barawn/radiant/README.md

# radiant
Hardware files and firmware for RADIANT

Schematic should be complete, including FPGA pinout.

# PCB files, bill of materials

See "Releases" for everything bundled together.
