barawn/radiant/CAMv3/README.txt

radiantv3.gtl : Top Copper
radiantv3.gl2 : Inner Layer 2
radiantv3.gl3 : Inner Layer 3
radiantv3.gl4 : Inner Layer 4
radiantv3.gl5 : Inner Layer 5
radiantv3.gl6 : Inner Layer 6
radiantv3.gl7 : Inner Layer 7
radiantv3.gbl : Bottom Copper
radiantv3.gto : Top Silkscreen
radiantv3.gbo : Bottom Silkscreen
radiantv3.gts : Top Soldermask
radiantv3.gbs : Bottom Soldermask
radiantv3.gtp : Top Solderpaste
radiantv3.gbp : Bottom Solderpaste
radiantv3.gko : Outline

radiantv3.txt : NC Drill

Designed with a stackup of

top 1 oz copper
5.9 mils (2x1080)
inner layer 2 1 oz copper
9 mils (core)
inner layer 3 1 oz copper
7.3 mils (7628)
inner layer 4 1 oz copper
5.1 mils (core)
inner layer 5 1 oz copper
7.3 mils (7628)
inner layer 6 1 oz copper
9 mils (core)
inner layer 7 1 oz copper
5.9 mils (2x1080)
bottom 1 oz copper
