barawn/radiant/CAM/README.txt

radiantv2.gtl : Top Copper
radiantv2.gl2 : Inner Layer 2
radiantv2.gl3 : Inner Layer 3
radiantv2.gl4 : Inner Layer 4
radiantv2.gl5 : Inner Layer 5
radiantv2.gl6 : Inner Layer 6
radiantv2.gl7 : Inner Layer 7
radiantv2.gbl : Bottom Copper
radiantv2.gto : Top Silkscreen
radiantv2.gbo : Bottom Silkscreen
radiantv2.gts : Top Soldermask
radiantv2.gbs : Bottom Soldermask
radiantv2.gtp : Top Solderpaste
radiantv2.gbp : Bottom Solderpaste

radiantv2.txt : NC Drill

Designed with a stackup of

top 1 oz copper
5.9 mils (2x1080)
inner layer 2 1 oz copper
9 mils (core)
inner layer 3 1 oz copper
7.3 mils (7628)
inner layer 4 1 oz copper
5.1 mils (core)
inner layer 5 1 oz copper
7.3 mils (7628)
inner layer 6 1 oz copper
9 mils (core)
inner layer 7 1 oz copper
5.9 mils (2x1080)
bottom 1 oz copper
