barawn/radiant/radiant_v3_bom.xlsx

Line # | Qty | Ref Des | Part Name (internal use) | Part Decal (internal use) | Manufacturer | Part Number | Description
1 | 1 | L15 | 744314330 | IND_744314330 | Wurth Elektronik | 744314330 | FIXED IND 3.3UH 9A 9 MOHM SMD
2 | 1 | J15 | 2147110001 | 21471100001 | Molex | 204711-0001 | Vertical Type C Usb Connector Rohs Compliant: Yes
3 | 24 | R1A R1B R1C R1D R1E R1F R1G R1H R1I R1J R1K R1L R1M R1N R1O R1P R1Q R1R R1S R1T R1U R1V R1W R1X | 1005L_OPTION,DNI | 1005L_PAD_OPTION | DNI |  | DNI
4 | 1 | J7 | 1888174-6 | 1888174-2 | TE Connectivity | 1888174-2 | CONN MINI SAS RCPT 36POS SLD SMD
5 | 4 | J18-21 | 1909763-1 | 1909763-1 | TE Connectivity | 1909763-1 | TE CONNECTIVITY - 1909763-1 - RF COAXIAL, UMCC, JACK, 50 OHM, PCB
6 | 1 | J17 | 20021121-00010C4LF | 2002112100010C4LF | Amphenol | 20021121-00010C4LF | Headers & Wire Housings 1.27x1.27mm BTB, Hdr Unshrd, SMT, 10 Pos
7 | 6 | S4-9 | 2182LPSTF | 2182LPSTF | CTS | 2182LPSTF | DIP SW,Half-pitch,2-pos,flush act, SMD 2 Way Surface Mount DIP Switch SPDT, Piano Actuator
8 | 1 | J12 | 5566-4 | 5566-4 | Molex | 39281043 | Mini-Fit Jr. Vertical Header, 4.20mm Pitch, Dual Row, 4 Circuits, without Snap-in Plastic Peg PCB Lock, Tin, Natural
9 | 1 | U4 | 74AUP1T50 | SC70-5 | TI | SN74AUP1T50DCKR | Low Power, 1.8/2.5/3.3-V Input, 3.3-V CMOS Output, Single Schmitt-Trigger Buffer Gate 5-SC70 -40 to 85
10 | 30 | U5-6 U37-39 U42-66 | 74HC4051BQ_115 | SOT763-1 | Nexperia | 74HC4051BQ,115 | 74HC4052BQ,115 Nexperia, Multiplexer Switch IC, 16-Pin DHVQFN
11 | 1 | U1 | ADF4351BCPZRL7 | QFN50P500X500X10033N | Analog | ADF4351BCPZ-RL7 | Wideband_Synthesizer_with_Integrated_VCO
12 | 6 | V1 V10 V27 V36 V45 V54 | AOZ1375DI | SON45P300X300X8013N165X238 | Alpha & Omega | AOZ1375DI-01 | IC PWR SWITCH N-CHAN 1:1 12DFN
13 | 1 | U8 | ATSAMD21J1XX-MU | QFN5-9X9-64-EP-65 | Microchip | ATSAMD21J18A-MU | MICROCHIP - ATSAMD21J18A-MU - MCU, 32BIT, CORTEX-M0+, 48MHZ, QFN-64
14 | 1 | S16 | B3U-1100PM-B | B3U-1100P-B | Omron | B3U-1100P | Switch Tactile N.O. SPST Round Button Gull Wing 0.05A 12VDC 1.5N SMD Embossed T/R
15 | 24 | U2A U2B U2C U2D U2E U2F U2G U2H U2I U2J U2K U2L U2M U2N U2O U2P U2Q U2R U2S U2T U2U U2V U2W U2X | BGA420 | SOT-343-BGA420 | Infineon | BGA420H6327XTSA1 | BGA420 Series 2.3 dB 6 V Surface Mount Si-MMIC Amplifier - SOT-343
16 | 24 | U1A U1B U1C U1D U1E U1F U1G U1H U1I U1J U1K U1L U1M U1N U1O U1P U1Q U1R U1S U1T U1U U1V U1W U1X | BGA-2851 | SOT-363 | NXP | BGA2802,115 | RF Amplifier IC General Purpose 0Hz ~ 2.2GHz 6-TSSOP
17 | 44 | C274-281 C284-291 C294-297 C478-485 C488-495 C498-501 CX497-498 CX500-501 | CAPACITOR_LST,0.1 uF-0201 | CAP0603L | Taiyo Yuden | LMK063C6104KP-F | CAP CER MLCC - SMD/SMT 0201 10V 0.1uF 10% X6S
18 | 347 | C48 C51 C56 C60 C62 C64 C66 C68 C70 C72-73 C80 C84 C86 C95 C97-101 C107-108 C110 C112 C117 C119 C121 C131-132 C134 C136 C148 C150 C161 C163 C171 C173 C177 C182 C184 C195 C197 C208 C210 C221 C223 C229 C232 C234-235 C242 C244-245 C253 C261 C298-299 C308 C310 C321 C323 C334 C336 C347 C349 C355 C358-359 C368 C370 C381 C383 C394 C396 C407 C409 C415 C418-419 C428 C430 C441 C443 C454 C456 C467 C469 C475 C502-503 C573-575 CX2-3 CX8-24 CX26-27 CX32-36 CX38-39 CX44-48 CX50-51 CX56-60 CX62 CX64 CX66 CX68-69 CX71-72 CX74-77 CX82 CX84-85 CX90-94 CX96 CX98-99 CX104-108 CX110 CX112-113 CX118-122 CX124 CX142-143 CX145-149 CX156 CX158-159 CX164-168 CX172 CX174-175 CX180-184 CX188 CX190-191 CX196-200 CX204 CX206-207 CX209-213 CX220 CX222-223 CX228-232 CX236 CX238-239 CX244-248 CX252 CX254-255 CX260-264 CX268 CX270-271 CX273-277 CX284 CX286-287 CX292-296 CX300 CX302-303 CX308-312 CX316 CX318-319 CX324-328 CX332 CX334-335 CX337-341 CX348 CX350-351 CX356-360 CX364 CX366-367 CX372-376 CX380 CX382-383 CX388-392 CX396-436 CX438 CX443-444 CX489 CX552-557 | CAPACITOR_LST,0.1u | CAP1005L | KEMET | C0402C104K4RECAUTO | CAP CER MLCC - SMD/SMT 16V 0.1uF X7R 0402 10% AEC-Q200
19 | 105 | C505-529 C547-569 CX441 CX458-471 CX473-475 CX481-487 CX492-495 CX504-507 CX510-513 CX516-519 CX522-525 CX529-532 CX535-538 CX541-544 | CAPACITOR_LST,0.47u | CAP0603L | Taiyo Yuden | LMK063BC6474KPLF | CAP CER MLCC - SMD/SMT 0201 10V 0.47uF 10% X6S
20 | 96 | C1A C1B C1C C1D C1E C1F C1G C1H C1I C1J C1K C1L C1M C1N C1O C1P C1Q C1R C1S C1T C1U C1V C1W C1X C5A C5B C5C C5D C5E C5F C5G C5H C5I C5J C5K C5L C5M C5N C5O C5P C5Q C5R C5S C5T C5U C5V C5W C5X C6A C6B C6C C6D C6E C6F C6G C6H C6I C6J C6K C6L C6M C6N C6O C6P C6Q C6R C6S C6T C6U C6V C6W C6X C7A C7B C7C C7D C7E C7F C7G C7H C7I C7J C7K C7L C7M C7N C7O C7P C7Q C7R C7S C7T C7U C7V C7W C7X | CAPACITOR_LST,1 nF | CAP1005L | TDK | CGA2B2C0G1H102J050BA
21 | 165 | C2-4 C6-7 C9-15 C18-23 C26-31 C82 C87 C89 C91 C93 C123-126 C128 C138-142 C144-146 C152-158 C165-169 C179 C185 C188-192 C198 C201-205 C211 C214-218 C224 C231 C255 C263 C301-305 C311 C314-318 C324 C327-331 C337 C340-344 C350 C357 C361-365 C371 C374-378 C384 C387-391 C397 C400-404 C410 C417 C421-425 C431 C434-438 C444 C447-451 C457 C460-464 C470 C477 C576-581 CX437 CX545-550 | CAPACITOR_LST,1 uF | CAP1005L | Murata | GRM155C81C105KE11J | CAP CER MLCC - SMD/SMT 1.0UF 16V 10% 0402
22 | 217 | C81 C83 C85 C94 C96 C109 C111 C116 C118 C133 C135 C147 C149 C160 C162 C170 C172 C178 C181 C183 C194 C196 C207 C209 C220 C222 C230 C233 C243 C256-257 C264-265 C271 C282-283 C292-293 C307 C309 C320 C322 C333 C335 C346 C348 C356 C367 C369 C380 C382 C393 C395 C406 C408 C416 C427 C429 C440 C442 C453 C455 C466 C468 C476 C486-487 C496-497 C570 C572 CX1 CX4-7 CX25 CX28-31 CX37 CX40-43 CX49 CX52-55 CX61 CX63 CX65 CX67 CX70 CX73 CX78-81 CX83 CX86-89 CX95 CX97 CX100-103 CX109 CX111 CX114-117 CX123 CX141 CX144 CX150-152 CX155 CX157 CX160-163 CX171 CX173 CX176-179 CX187 CX189 CX192-195 CX203 CX205 CX208 CX214-216 CX219 CX221 CX224-227 CX235 CX237 CX240-243 CX251 CX253 CX256-259 CX267 CX269 CX272 CX278-280 CX283 CX285 CX288-291 CX299 CX301 CX304-307 CX315 CX317 CX320-323 CX331 CX333 CX336 CX342-344 CX347 CX349 CX352-355 CX363 CX365 CX368-371 CX379 CX381 CX384-387 CX395 CX439-440 | CAPACITOR_LST,10 uF | CAP1608L | Taiyo Yuden | LMK107BBJ106KALT | CAP CER MLCC - SMD/SMT 0603 10V 10uF 10% X5R
23 | 24 | C1 C5 C17 C25 C122 C137 C143 C151 C164 C187 C200 C213 C300 C313 C326 C339 C360 C373 C386 C399 C420 C433 C446 C459 | CAPACITOR_LST,100p | CAP1005L | TDK | CGA2B2C0G2A101J050BE | CAP CER MLCC - SMD/SMT 0402 100V 100pF 5% SOFT 0.50mm AEC-Q200
24 | 1 | CX472 | CAPACITOR_LST,100u | CAP3216L | Samsung | CL31A107MQHNNNE | CAP CER 100UF 6.3V X5R 1206
25 | 223 | C38 C49 C57 C77-79 C102-103 C113-115 C120 C127 C129-130 C159 C174-176 C180 C193 C206 C219 C226-228 C306 C319 C332 C345 C352-354 C366 C379 C392 C405 C412-414 C426 C439 C452 C465 C472-474 C534 C541-546 C571 C10A C10B C10C C10D C10E C10F C10G C10H C10I C10J C10K C10L C10M C10N C10O C10P C10Q C10R C10S C10T C10U C10V C10W C10X C18A C18B C18C C18D C18E C18F C18G C18H C18I C18J C18K C18L C18M C18N C18O C18P C18Q C18R C18S C18T C18U C18V C18W C18X C19A C19B C19C C19D C19E C19F C19G C19H C19I C19J C19K C19L C19M C19N C19O C19P C19Q C19R C19S C19T C19U C19V C19W C19X C27A C27B C27C C27D C27E C27F C27G C27H C27I C27J C27K C27L C27M C27N C27O C27P C27Q C27R C27S C27T C27U C27V C27W C27X C9A C9B C9C C9D C9E C9F C9G C9H C9I C9J C9K C9L C9M C9N C9O C9P C9Q C9R C9S C9T C9U C9V C9W C9X CX561-608 | CAPACITOR_LST,10n | CAP1005L | Murata | GRM1555CYA103GE01D | CAP CER 10000PF 35V C0G/NP0 0402
26 | 61 | C40 C50 C55 C58-59 C61 C63 C65 C67 C69 C71 C252 C260 C12A C12B C12C C12D C12E C12F C12G C12H C12I C12J C12K C12L C12M C12N C12O C12P C12Q C12R C12S C12T C12U C12V C12W C12X C21A C21B C21C C21D C21E C21F C21G C21H C21I C21J C21K C21L C21M C21N C21O C21P C21Q C21R C21S C21T C21U C21V C21W C21X | CAPACITOR_LST,10p | CAP1005L | KEMET | C0402C100K8GACTU | CAP CER 10PF 10V NP0 0402
27 | 1 | C237 | CAPACITOR_LST,150p | CAP1005L | KEMET | C0402C151J3GAC7867 | CAP CER 150PF 25V NP0 0402
28 | 19 | C41 C28M C28N C28O C28P C28Q C28R C28S C28T C28U C29M C29N C29O C29P C29Q C29R C29S C29T C29U | CAPACITOR_LST,15p | CAP1005L | KEMET | C0402C150G5HACAUTO | CAP CER MLCC - SMD/SMT 50V 15pF X8R 0402 2% AEC-Q200
29 | 1 | C34 | CAPACITOR_LST,16p | CAP1005L | Murata | GJM1555C1H160GB01D | CAP CER MLCC - SMD/SMT 0402 16pF 50Volts C0G 2%
30 | 48 | C13A C13B C13C C13D C13E C13F C13G C13H C13I C13J C13K C13L C13M C13N C13O C13P C13Q C13R C13S C13T C13U C13V C13W C13X C22A C22B C22C C22D C22E C22F C22G C22H C22I C22J C22K C22L C22M C22N C22O C22P C22Q C22R C22S C22T C22U C22V C22W C22X | CAPACITOR_LST,2.2p | CAP1005L | AVX | 04025A2R2KAT2A | CAP CER 2.2PF 50V C0G/NP0 0402
31 | 10 | C52 C238 C248 C254 C262 C272 C530-533 | CAPACITOR_LST,2.7n | CAP1005L | KEMET | C0402C272K5RACAUTO | MLCC - SMD/SMT 50V 2700pF X7R 0402 10% AEC-Q200
32 | 1 | C42 | CAPACITOR_LST,2.7p | CAP1005L | KEMET | CBR04C279A5GAC | CAP CER MLCC - SMD/SMT 50V 2.7pF C0G 0402 0.05pF
33 | 1 | C33 | CAPACITOR_LST,20p | CAP1005L | KEMET | C0402C200F4HACAUTO | CAP CER MLCC - SMD/SMT 16V 20pF X8R 0402 1% AEC-Q200
34 | 26 | C104-105 C8A C8B C8C C8D C8E C8F C8G C8H C8I C8J C8K C8L C8M C8N C8O C8P C8Q C8R C8S C8T C8U C8V C8W C8X | CAPACITOR_LST,220p | CAP1005L | KEMET | C0402C221J5RACAUTO | MLCC - SMD/SMT 50V 220pF X7R 0402 5% AEC-Q200
35 | 1 | C246 | CAPACITOR_LST,22n | CAP1005L | Murata | GRM155R71E223KA61D | CAP CER 0.022UF 25V X7R 0402
36 | 5 | C258-259 C266-267 C270 | CAPACITOR_LST,22u | CAP3216L | Taiyo Yuden | JMK316AB7226KL-TR | CAP CER MLCC - SMD/SMT 1206 6.3VDC 22uF 10% X7R
37 | 6 | C535-540 | CAPACITOR_LST,27n | CAP1005L | KEMET | C0402C273K8RACTU | Multilayer Ceramic Capacitors MLCC - SMD/SMT 10V 0.027uF X7R 0402 10%
38 | 25 | C37 C3A C3B C3C C3D C3E C3F C3G C3H C3I C3J C3K C3L C3M C3N C3O C3P C3Q C3R C3S C3T C3U C3V C3W C3X | CAPACITOR_LST,27p | CAP1005L | Taiyo Yuden | UMK105CH270JVHF | CAP CER 27PF 50V CH 0402
39 | 48 | C14A C14B C14C C14D C14E C14F C14G C14H C14I C14J C14K C14L C14M C14N C14O C14P C14Q C14R C14S C14T C14U C14V C14W C14X C23A C23B C23C C23D C23E C23F C23G C23H C23I C23J C23K C23L C23M C23N C23O C23P C23Q C23R C23S C23T C23U C23V C23W C23X | CAPACITOR_LST,36p | CAP1005L | KEMET | CBR04C360F5GAC | CAP CER MLCC - SMD/SMT 50V 36pF C0G 0402 1%
40 | 1 | C236 | CAPACITOR_LST,39.0n | CAP1005L | Murata | GRM155R71H393KE14D | Cap Ceramic 0.039uF 50V X7R 10% Pad SMD 0402 125C T/R
41 | 48 | C17A C17B C17C C17D C17E C17F C17G C17H C17I C17J C17K C17L C17M C17N C17O C17P C17Q C17R C17S C17T C17U C17V C17W C17X C26A C26B C26C C26D C26E C26F C26G C26H C26I C26J C26K C26L C26M C26N C26O C26P C26Q C26R C26S C26T C26U C26V C26W C26X | CAPACITOR_LST,39p | CAP1005L | KEMET | C0402C390F5HACTU | CAP CER MLCC - SMD/SMT 50V 39pF X8R 0402 1%
42 | 109 | C8 C16 C24 C32 C88 C90 C92 C106 C186 C199 C212 C225 C268 C312 C325 C338 C351 C372 C385 C398 C411 C432 C445 C458 C471 CX125-140 CX153-154 CX169-170 CX185-186 CX201-202 CX217-218 CX233-234 CX249-250 CX265-266 CX281-282 CX297-298 CX313-314 CX329-330 CX345-346 CX361-362 CX377-378 CX393-394 CX442 CX446-457 CX477-480 CX490-491 CX496 CX499 CX502-503 CX508-509 CX514-515 CX520-521 CX527-528 CX533-534 CX539-540 CX551 | CAPACITOR_LST,4.7u | CAP1005L | AVX | 0402ZD475KAT2A | CAP CER MLCC - SMD/SMT 10V 4.7uF X5R 0402 0.1
43 | 4 | C239-240 C249-250 | CAPACITOR_LST,47 uF-1206 | CAP3216L | Taiyo Yuden | LMK316ABJ476ML-T | 1206 47 uF 10 V ±20% Tolerance X5R SMT Multilayer Ceramic Capacitor
44 | 7 | C44-47 C74-76 | CAPACITOR_LST,470p | CAP1005L | TDK | CGA2B2C0G2A471J050BE | CAP CER MLCC - SMD/SMT 0402 100V 470pF 5% SOFT C0G AEC-Q200
45 | 1 | C53 | CAPACITOR_LST,47n | CAP1005L | Yageo | CC0402KRX7R6BB473 | CAP CER 0.047UF 10V X7R 0402
46 | 1 | C35 | CAPACITOR_LST,47p | CAP1005L | Murata | GJM1555C1H470FB01D | CAP CER MLCC - SMD/SMT 47PF 50V 1% 0402
47 | 3 | C241 C251 C582 | CAPACITOR_LST,47u | CAP3225L | Taiyo Yuden | TMK325ABJ476MM-T | CAP CER 47UF 25V X5R 1210
48 | 4 | C269 CX476 CX488 CX526 | CAPACITOR_LST,47u | CAP2012L | Murata | GRM21BR60J476ME15L | CAP CER MLCC - SMD/SMT 0805 47uF 6.3volts *Derate Voltage/Temp
49 | 2 | C36 C39 | CAPACITOR_LST,5.6p | CAP1005L | AVX | 04025U5R6B4T2A | CAP CER MLCC - SMD/SMT 50V 5.6pF C0G 0402 0.1pF To
50 | 1 | C54 | CAPACITOR_LST,680p | CAP1005L | TDK | C1005C0G2A681J050BE | CAP CER MLCC - SMD/SMT 0402 100V 680pF 5% SOFT 0.50mm
51 | 97 | C247 C15A C15B C15C C15D C15E C15F C15G C15H C15I C15J C15K C15L C15M C15N C15O C15P C15Q C15R C15S C15T C15U C15V C15W C15X C16A C16B C16C C16D C16E C16F C16G C16H C16I C16J C16K C16L C16M C16N C16O C16P C16Q C16R C16S C16T C16U C16V C16W C16X C24A C24B C24C C24D C24E C24F C24G C24H C24I C24J C24K C24L C24M C24N C24O C24P C24Q C24R C24S C24T C24U C24V C24W C24X C25A C25B C25C C25D C25E C25F C25G C25H C25I C25J C25K C25L C25M C25N C25O C25P C25Q C25R C25S C25T C25U C25V C25W C25X | CAPACITOR_LST,68p | CAP1005L | KEMET | C0402C680J5GACAUTO | CAP CER MLCC - SMD/SMT 50V 68pF C0G 0402 5% AEC-Q200
52 | 48 | C11A C11B C11C C11D C11E C11F C11G C11H C11I C11J C11K C11L C11M C11N C11O C11P C11Q C11R C11S C11T C11U C11V C11W C11X C20A C20B C20C C20D C20E C20F C20G C20H C20I C20J C20K C20L C20M C20N C20O C20P C20Q C20R C20S C20T C20U C20V C20W C20X | CAPACITOR_LST,7.5p | CAP1005L | Murata | GJM1555C1H7R5BB01D | CAP CER MLCC - SMD/SMT 0402 7.5pF 50Volts C0G +/-0.1pF
53 | 24 | C4A C4B C4C C4D C4E C4F C4G C4H C4I C4J C4K C4L C4M C4N C4O C4P C4Q C4R C4S C4T C4U C4V C4W C4X | CAPACITOR_LST,82p | CAP1005L | Taiyo Yuden | UMK105CH820JVHF | CAP CER 82PF 50V CH 0402
54 | 1 | C43 | CAPACITOR_LST,9.1p | CAP1005L | KEMET | CBR04C919B5GAC | MLCC - SMD/SMT 50V 9.1pF C0G 0402 0.1pF
55 | 30 | C28A C28B C28C C28D C28E C28F C28G C28H C28I C28J C28K C28L C28V C28W C28X C29A C29B C29C C29D C29E C29F C29G C29H C29I C29J C29K C29L C29V C29W C29X | CAPACITOR_LST,DNI | CAP1005L | DNI | DNI | DNI
56 | 24 | C2A C2B C2C C2D C2E C2F C2G C2H C2I C2J C2K C2L C2M C2N C2O C2P C2Q C2R C2S C2T C2U C2V C2W C2X | CAPACITOR_LST_SQ,82p | CAP1005L_SQUARE | Taiyo Yuden | UMK105CH820JVHF | CAP CER 82PF 50V CH 0402
57 | 24 | C30A C30B C30C C30D C30E C30F C30G C30H C30I C30J C30K C30L C30M C30N C30O C30P C30Q C30R C30S C30T C30U C30V C30W C30X | CAPACITOR_LST_SQ,DNI | CAP1005L_SQUARE | DNI | DNI | DNI
58 | 3 | CX558-560 | CAPPOL_SMT,47 uF | CAPT7343HL | AVX | TCJY476M020R0070E | CAP TANT POLY 47UF 20V 2917
59 | 1 | CX445 | CAPPOL_SMT,680 uF | CAPT7343HL | Panasonic | 2R5TAE680ML | Cap Tant Solid 680uF 2.5V D3L CASE 20% (7.3 X 4.3 X 2.8mm) SMD 7343-30 0.025 Ohm 105°C T/R
60 | 2 | U14 U35 | CDCLVD1212RHAT | QFN50P600X600X10041N | Texas Instruments | CDCLVD1212RHAT | Low Jitter, 2-Input Selectable 1:12 Universal-to-LVDS Buffer
61 | 2 | L16-17 | CLF7045NIT-3R3N-D | INDM7470X480N | TDK | CLF7045NIT-3R3N-D | Fixed Inductors 3.3uH 0.016ohms 4.7A 30% AEC-Q200
62 | 2 | J1 J3 | CON-SIP-1P | SIP-1P | DNI | DNI | DNI
63 | 1 | J24 | CON-SIP-3P | SIP-3P | DNI | DNI | GENERIC 3 PIN SIP HEADER .100 CENTERS
64 | 6 | J2 J4-5 J8-10 | CON-SIP-4P | SIP-4P-LOCKING | DNI | DNI | DNI
65 | 49 | D1-24 D27 D30-53 | DIODE-SMD | DIOSOD-323 | Toshiba | CUS08F30,H3F
66 | 1 | Z1 | DIODE-ZENER-SMD,10V | DIOSOD-523 | Diodes, Inc. | BZT52C12T-7
67 | 1 | Y1 | DSC6001 | 7M_32X25 | Microchip | DSC6001CI1A-010.0000 | MEMS OSC XO 10.0000MHZ CMOS SMD
68 | 5 | D25-26 D28-29 D54 | DT1446 | DT1446 | Diodes, Inc. | DT1446-04S-7 | TVS DIODE 5V 8.5V SOT363
69 | 6 | L5-10 | FERRITE | 402 | Murata | BLM15PX800SN1D
70 | 1 | J22 | HEADER02 | SIP-2P | DNI | DNI | DNI
71 | 2 | J25-26 | HEADER02 | SIP-2P |  |  | TWO PIN INLINE HEADER; 100 MIL CENTERS
72 | 1 | J23 | HEADER02-1 | SIP-2P |  |  | TWO PIN HEADER; 100 MIL CENTERS; INLINE
73 | 15 | L10A L10B L10C L10D L10E L10F L10G L10H L10I L10J L10K L10L L10V L10W L10X | INDUCTOR,0 | 603 | Stackpole | RMCF0603ZT0R00 | 0 ohm 0603 resistor (short)
74 | 102 | L11-13 L20-22 L4A L4B L4C L4D L4E L4F L4G L4H L4I L4J L4K L4L L4M L4N L4O L4P L4Q L4R L4S L4T L4U L4V L4W L4X L5A L5B L5C L5D L5E L5F L5G L5H L5I L5J L5K L5L L5M L5N L5O L5P L5Q L5R L5S L5T L5U L5V L5W L5X L7A L7B L7C L7D L7E L7F L7G L7H L7I L7J L7K L7L L7M L7N L7O L7P L7Q L7R L7S L7T L7U L7V L7W L7X L8A L8B L8C L8D L8E L8F L8G L8H L8I L8J L8K L8L L8M L8N L8O L8P L8Q L8R L8S L8T L8U L8V L8W L8X | INDUCTOR,120n | 603 | Murata | LQW18ASR12G0ZD
75 | 48 | L6A L6B L6C L6D L6E L6F L6G L6H L6I L6J L6K L6L L6M L6N L6O L6P L6Q L6R L6S L6T L6U L6V L6W L6X L9A L9B L9C L9D L9E L9F L9G L9H L9I L9J L9K L9L L9M L9N L9O L9P L9Q L9R L9S L9T L9U L9V L9W L9X | INDUCTOR,150n | 603 | Wurth Elektronik | 744917215
76 | 24 | L3A L3B L3C L3D L3E L3F L3G L3H L3I L3J L3K L3L L3M L3N L3O L3P L3Q L3R L3S L3T L3U L3V L3W L3X | INDUCTOR,1u | 805 | Taiyo Yuden | LBR2012T1R0M
77 | 1 | L3 | INDUCTOR,20n | 805 | Murata | LQW2BAN20NG00L | FIXED IND 20NH 2.2A 50 MOHM
78 | 1 | L4 | INDUCTOR,33n | 805 | Murata | LQW2BAN33NG00L | FIXED IND 33NH 1.5A 120 MOHM
79 | 9 | L10M L10N L10O L10P L10Q L10R L10S L10T L10U | INDUCTOR,43n | 603 | Murata | LQW18AN43NG00D | CERAMIC CHIP INDUCTORS 43NH
80 | 1 | L1 | INDUCTOR,68n | 805 | Murata | LQW2BAN68NG00L | FIXED IND 68NH 1.25A 200 MOHM
81 | 48 | L1A L1B L1C L1D L1E L1F L1G L1H L1I L1J L1K L1L L1M L1N L1O L1P L1Q L1R L1S L1T L1U L1V L1W L1X L2A L2B L2C L2D L2E L2F L2G L2H L2I L2J L2K L2L L2M L2N L2O L2P L2Q L2R L2S L2T L2U L2V L2W L2X | INDUCTOR,82n | 805 | Murata | LQW2BAN82NJ00L | FIXED IND 82NH 1.2A 240 MOHM
82 | 1 | L2 | INDUCTOR,91n | 805 | Murata | LQW2BAN91NJ00L | FIXED IND 91NH 1.3A 210 MOHM
83 | 1 | L18 | INDUCTOR-SMD2,4.7u | IND2520L | TDK | MLP2520S4R7ST0S1 | FIXED IND 4.7UH 1A 110 MOHM SMD
84 | 1 | J16 | JTAG_2MM | 878321422 | Molex | 87832-1422 | Conn Shrouded Header (4 Sides) HDR 14 POS 2mm Solder ST Top Entry SMD Milli-Grid™ Tube
85 | 24 | LAB1-24 | LAB4D | LAB4D | Customer Supplied | LAB4D | Customer Supplied
86 | 2 | U13 U34 | LCMXO2-2K/4K/7K-BG256 | BGA256C80P16X16_1400X1400X170 | Lattice | LCMXO2-2000HC-4BG256I | IC FPGA 206 I/O 256CABGA
87 | 1 | F1 | LP_FILT_8TERM | JOHANSON-LP15 | Johanson | 0500LP15A500E | RF FILTER LOW PASS 500MHZ 0805
88 | 1 | S3 | MASW-007935 | SOT-23-6 | M/A-COM | MASW-007935-TR3000 | IC RF SWITCH SPDT 3GHZ SOT26
89 | 6 | U3 U9 U16 U25 U28 U31 | MCP4728 | MSOP10_MC | Microchip | MCP4728T-E/UN | IC DAC 12BIT V-OUT 10MSOP
90 | 2 | U69-70 | MCP4725A0T-E_CH | SOT95P270X145-6N | Microchip | MCP4725A0T-E/CH | D/A Converter 12-Bit EEPROM I2C SOT23-6
91 | 24 | V58-81 | MCP6L01 | SOT-23-5L | Microchip | MCP6L01T-E/OT | IC OPAMP GP 1 CIRCUIT SOT23-5
92 | 25 | J1A J1A1 J1B J1C J1D J1E J1F J1G J1H J1I J1J J1K J1L J1M J1N J1O J1P J1Q J1R J1S J1T J1U J1V J1W J1X | MCX_CONN | MCX_VERT |  | 733660061 | CONN MCX JACK STR 50 OHM PCB
93 | 1 | V56 | MIC47050 | MLF22D-06L | Microchip | MIC47050-1.2YML-TR | MIC47050 Series 1.2 V Fixed Output 500 mA SMT LDO Voltage Regulator - MLF-6
94 | 1 | V55 | MIC47053 | MLF22D-08L | Microchip | MIC47053YMT-TR | 500Ma Adjustable Micropower Uldo, Linear Regulator With Power Good, 8 Udfn 2X2x0.6Mm T/R
95 | 24 | V3-9 V11 V20 V22 V24 V26 V29 V31 V33 V35 V38 V40 V42 V44 V47 V49 V51 V53 | MIC94310-GYMT-TR | SON50P155X120X60-5N-D | Micrel | MIC94310-PYMT-T5 | LDO Voltage Regulators 200mA Ripple Blocker, with Fixed Output Voltage Follower
96 | 24 | V2 V12-19 V21 V23 V25 V28 V30 V32 V34 V37 V39 V41 V43 V46 V48 V50 V52 | MIC94325YMT-T5 | SON50P160X160X60-7N | Microchip | MIC94325YMT-T5 | Microchip MIC94325YMT-T5, LDO Regulator, 500mA Adjustable, 1.2 to 3.4 V, 3%, TDFN 6-Pin
97 | 1 | J13 | MICROSD_SOCKET | MICROSD_SOCKET | Molex | 1050270001 | Conn Micro SD Card HDR 8 POS 1.1mm Solder RA SMD Embossed T/R 0.5A/Contact
98 | 1 | J14 | MICRO_USB_B | MICRO_USB_SMT_JAE_DX4 | JAE | DX4R005HJ5R2000
99 | 74 | TP47 TP74 TP1A TP1B TP1C TP1D TP1E TP1F TP1G TP1H TP1I TP1J TP1K TP1L TP1M TP1N TP1O TP1P TP1Q TP1R TP1S TP1T TP1U TP1V TP1W TP1X TP2A TP2B TP2C TP2D TP2E TP2F TP2G TP2H TP2I TP2J TP2K TP2L TP2M TP2N TP2O TP2P TP2Q TP2R TP2S TP2T TP2U TP2V TP2W TP2X TP3A TP3B TP3C TP3D TP3E TP3F TP3G TP3H TP3I TP3J TP3K TP3L TP3M TP3N TP3O TP3P TP3Q TP3R TP3S TP3T TP3U TP3V TP3W TP3X | MM81302600RA2 | MURATA_MM81302600RA2 | Murata | MM8130-2600RA2 | CONN SWF RCPT STR 50 OHM SMD
100 | 6 | U11 U15 U18 U27 U30 U33 | MMG3H21NT1 | SOT-89 | NXP | MMG3H21NT1 | IC RF AMP 0HZ-6GHZ SOT89-4
101 | 2 | SH17-18 | MS130-10 | MS130-10-NOSHIELD | Masach | MS130-10 | 13 x 13 x 5mm Drawn RF Shield/EMI Shield Two-piece Tin Steel SMD
102 | 24 | SH1-12 SH19-30 | MS220-30 | MS220-30 | Masach | MS220-30 | Board Mount EMI Enclosures 22 x 11.3 x 2.8mm RF Shield/EMI Shield Two-piece Tin Steel SMD
103 | 4 | SH13-16 | MS293-20 | MS293-20 | Masach | MS293-20 | Board Mount EMI Enclosures 29.3 x 16.3 x 9.7mm RF Shield/EMI Shield Two-piece Tin Steel SMD
104 | 18 | X29-44 X46-47 | MTG_HOLE | MTHOLE-NUMBER-4 | DNI | DNI | DNI
105 | 24 | C586-609 | NFM18PC105R0J3D | NFM18PC105R0J3D | Murata | NFM18PC105R0J3D | EMIFIL FILTER NFM18P Murata NFM18C Series, Signal Filter, 6.3 V dc, 2A 0603 SMD 1.6 x 0.8 x 0.8mm
106 | 5 | C273 C504 C583-585 | NFM31P | NFM31P_1206 | Murata | NFM31PC276B0J3L | NFM Series 1206 27 uF 6 A 6.3 V SMT Chip Capacitor Type EMI Filter
107 | 1 | U68 | NLSX5014MUTAG | QFN40P170X200X5512N | ON Semiconductor | NLSX5014MUTAG | NLSX5014:_4-Bit_100Mb/s_Configurable_Dual-Supply_Level_Translator
108 | 1 | Y2 | OSC_EN | 4SMD_2X2P5 | Microchip | DSC6001JI1A-050.0000
109 | 24 | A3A A3B A3C A3D A3E A3F A3G A3H A3I A3J A3K A3L A3M A3N A3O A3P A3Q A3R A3S A3T A3U A3V A3W A3X | PAT05S | PAT05S | Susumu | PAT0510S-C-2DB-T10 | RF ATTENUATOR 2DB 50OHM 0402
110 | 24 | R5A R5B R5C R5D R5E R5F R5G R5H R5I R5J R5K R5L R5M R5N R5O R5P R5Q R5R R5S R5T R5U R5V R5W R5X | RES0402_SQUARE,0 | RES1005L_SQUARE | Stackpole | RMCF0402ZT0R00 | Res Thick Film 0402 0 Ohm Jumper Molded SMD Paper T/R
111 | 54 | R47 R49 R51 R59 R61 R63 R65 R67 R163 R172 R177 R182 R187 R192 R197 R202 R233 R235 R251 R253 R269 R271 R287 R289 R346 R374 R376 R392 R394 R410 R412 R428 R430 R460 R462 R478 R480 R496 R498 R514 R516 R546 R548 R564 R566 R582 R584 R600 R602 R889-893 | RESISTOR,0 | 0402_MM | Stackpole | RMCF0402ZT0R00 | Res Thick Film 0402 0 Ohm Jumper Molded SMD Paper T/R
112 | 6 | R5 R28 R79 R82 R92 R102 | RESISTOR,0.01 | 0402_MM | Panasonic | ERJ-2LWFR010X | RES 0.01 OHM 1% 1/5W 0402
113 | 73 | R2-4 R14-16 R25-27 R36-38 R73 R112-114 R123-125 R134-136 R145-147 R220-222 R238-240 R256-258 R274-276 R361-363 R379-381 R397-399 R415-417 R447-449 R465-467 R483-485 R501-503 R533-535 R551-553 R569-571 R587-589 | RESISTOR,100 | 0402_MM | Yageo | RC0100FR-07100RL | Thick Film Resistors - SMD 100 OHM 1%
114 | 6 | R158 R204 R218 R357 R445 R531 | RESISTOR,100-0603 | 603 | TE Connectivity | CRGP0603F100R | Thick Film Resistors - SMD CRGP 0603 100R 1% SMD Resistor
115 | 51 | R88 R144 R155-156 R164-168 R173 R178 R183 R188 R193 R198 R203 R234 R237 R252 R255 R270 R273 R288 R291 R344 R375 R378 R393 R396 R411 R414 R429 R432 R461 R464 R479 R482 R497 R500 R515 R518 R547 R550 R565 R568 R583 R586 R601 R604 R723 R725 | RESISTOR,100k | 0402_MM | Yageo | RC0100FR-07100KL | Thick Film Resistors - SMD 100K OHM 1%
116 | 224 | R70 R72 R74 R84-87 R95-96 R99-100 R103 R105-106 R108-109 R122 R161 R170 R175 R180 R185 R190 R195 R200 R207-208 R211-213 R216 R231 R249 R267 R285 R342 R348-349 R351 R353-355 R372 R390 R408 R426 R433 R436 R438-440 R443 R458 R476 R494 R512 R519 R522-523 R525-526 R529 R544 R562 R580 R598 R643-644 R671 R673 R676-694 R696 R721-722 R729-849 R851 R865-866 R869 R872 R874 R876 R878 R880 R884-885 | RESISTOR,10k | 0402_MM | Yageo | RC0402FR-0710KL | Res General Purpose Thick Film 0402 10K Ohm 1% 1/16W ±100ppm/°C Molded SMD Paper T/R
117 | 24 | R160 R169 R174 R179 R184 R189 R194 R199 R230 R248 R266 R284 R371 R389 R407 R425 R457 R475 R493 R511 R543 R561 R579 R597 | RESISTOR,12.7k | 0402_MM | Yageo | RC0402FR-0710KL | Res General Purpose Thick Film 0402 10K Ohm 1% 1/16W ±100ppm/°C Molded SMD Paper T/R
118 | 24 | R294 R297 R300 R303 R306 R309 R312 R315 R318 R321 R324 R327 R607 R610 R613 R616 R619 R622 R625 R628 R631 R634 R637 R640 | RESISTOR,140 | 0402_MM | Yageo | RC0402FR-07140RL | 140 Ohms ±1% 0.063W, 1/16W Chip Resistor 0402 (1005 Metric) Moisture Resistant Thick Film
119 | 3 | R728 R853 R864 | RESISTOR,15.4k | 0402_MM | Stackpole | RMCF0402FT15K4 | 15.4 kOhms ±1% 0.063W, 1/16W Chip Resistor 0402 (1005 Metric) Automotive AEC-Q200 Thick Film
120 | 13 | R75 R133 R157 R159 R205 R217 R219 R356 R358 R444 R446 R530 R532 | RESISTOR,150 | 603 | Rohr | SFR03EZPF1500 | SMD 0603 150ohms 1% Anti-Sulfur AEC-Q200
121 | 48 | R292-293 R295-296 R298-299 R301-302 R304-305 R307-308 R310-311 R313-314 R316-317 R319-320 R322-323 R325-326 R605-606 R608-609 R611-612 R614-615 R617-618 R620-621 R623-624 R626-627 R629-630 R632-633 R635-636 R638-639 | RESISTOR,158 | 0402_MM | Yageo | RC0402FR-07158RL | RES SMD 158 OHM 1% 1/16W 0402
122 | 48 | R6-7 R18-19 R29-30 R40-41 R115-116 R126-127 R137-138 R148-149 R223-224 R241-242 R259-260 R277-278 R364-365 R382-383 R400-401 R418-419 R450-451 R468-469 R486-487 R504-505 R536-537 R554-555 R572-573 R590-591 | RESISTOR,16k | 0402_MM | Stackpole | RMCF0402FT16K0 | 16 kOhms ±1% 0.063W, 1/16W Chip Resistor 0402 (1005 Metric) Automotive AEC-Q200 Thick Film
123 | 25 | R8 R20 R31 R42 R54 R117 R128 R139 R150 R225 R243 R261 R279 R366 R384 R402 R420 R452 R470 R488 R506 R538 R556 R574 R592 | RESISTOR,1k | 0402_MM | Yageo | RC0402FR-071KL | RES SMD 1K OHM 1% 1/16W 0402
124 | 1 | R329 | RESISTOR,2.21k | 0402_MM | Yageo | RC0402FR-072K21L | RES 2.21K OHM 1% 1/16W 0402
125 | 1 | R330 | RESISTOR,20.0k | 0402_MM | Stackpole | RMCF0402JT20K0 | RES 20K OHM 5% 1/16W 0402
126 | 11 | R17 R39 R80-81 R93-94 R724 R867 R886-888 | RESISTOR,200k | 0402_MM | Stackpole | RMCF0402JT200K | RES 200K OHM 5% 1/16W 0402
127 | 2 | R339 R341 | RESISTOR,23.7k | 0402_MM | Yageo | RC0402FR-0723K7L | RES SMD 23.7K OHM 1% 1/16W 0402
128 | 1 | R335 | RESISTOR,24.9k | 0402_MM | Yageo | RC0402FR-0724K9L | RES SMD 24.9K OHM 1% 1/16W 0402
129 | 24 | R3A R3B R3C R3D R3E R3F R3G R3H R3I R3J R3K R3L R3M R3N R3O R3P R3Q R3R R3S R3T R3U R3V R3W R3X | RESISTOR,24k | 603 | Vishay/Dale | RCS060324K0FKEA | Thick Film Resistors - SMD 0.25watt 24Kohms 1% 100ppm
130 | 26 | R76 R727 R4A R4B R4C R4D R4E R4F R4G R4H R4I R4J R4K R4L R4M R4N R4O R4P R4Q R4R R4S R4T R4U R4V R4W R4X | RESISTOR,2k | 0402_MM | Stackpole | RMCF0402JT2K00 | RES 2K OHM 5% 1/16W 0402
131 | 1 | R340 | RESISTOR,32k | 0402_MM | KOA | RN73H1ETTP3202F50 | 32 kOhms ±1% 0.063W, 1/16W Chip Resistor 0402 (1005 Metric) Automotive AEC-Q200, Moisture Resistant Metal Film
132 | 8 | R850 R859-863 R870 R881 | RESISTOR,33 | 0402_MM | Stackpole | RMCF0402JT33R0 | RES 33 OHM 5% 1/16W 0402
133 | 2 | R53 R726 | RESISTOR,360 | 0402_MM | Yageo | RC0402FR-07360RL | 360 Ohms ±1% 0.063W, 1/16W Chip Resistor 0402 (1005 Metric) Moisture Resistant Thick Film
134 | 1 | R334 | RESISTOR,4.12k | 0402_MM | Stackpole | RMCF0402FT4K12 | RES 4.12K OHM 1% 1/16W 0402
135 | 24 | R697-720 | RESISTOR,4.7k | 0201_MMA | Stackpole | RMCF0201FT4K70 | RES 4.7K OHM 1% 1/20W 0201
136 | 1 | R55 | RESISTOR,4.7k-0402 | 0402_MM | Stackpole | RMCF0402JT4K70 | RES 4.7K OHM 5% 1/16W 0402
137 | 102 | R1 R11-13 R21-24 R32-35 R43-46 R118-121 R129-132 R140-143 R151-154 R226-229 R244-247 R262-265 R280-283 R367-370 R385-388 R403-406 R421-424 R453-456 R471-474 R489-492 R507-510 R539-542 R557-560 R575-578 R593-596 R852 R854-858 | RESISTOR,4.99k | 0402_MM | Stackpole | RMCF0402FT4K99 | RES 4.99K OHM 1% 1/16W 0402
138 | 1 | R343 | RESISTOR,43.0k | 0402_MM | Yageo | RC0402FR-0743KL | 43 kOhms ±1% 0.063W, 1/16W Chip Resistor 0402 (1005 Metric) Moisture Resistant Thick Film
139 | 1 | R56 | RESISTOR,475 | 603 | Vishay/Dale | CRCW0603475RFKEAC | Thick Film Resistors - SMD 1/10Watt 475ohms 1% Commercial Use
140 | 31 | R9-10 R52 R57 R101 R641-642 R2A R2B R2C R2D R2E R2F R2G R2H R2I R2J R2K R2L R2M R2N R2O R2P R2Q R2R R2S R2T R2U R2V R2W R2X | RESISTOR,49.9 | 0402_MM | Stackpole | RMCF0402FT49R9 | RES 49.9 OHM 1% 1/16W 0402
141 | 25 | R647-670 R868 | RESISTOR,49.9-0201 | 0201_MMA | Yageo | RC0201FR-0749R9L | Thick Film Resistors - SMD 49.9 OHM 1%
142 | 9 | R77 R695 R871 R873 R875 R877 R879 R882-883 | RESISTOR,49.9k | 0402_MM | Stackpole | RMCF0402FT49K9 | RES 49.9K OHM 1% 1/16W 0402
143 | 1 | R338 | RESISTOR,53.6k | 0402_MM | Stackpole | RMCF0402FT53K6 | 53.6 kOhms ±1% 0.063W, 1/16W Chip Resistor 0402 (1005 Metric) Automotive AEC-Q200 Thick Film
144 | 2 | R331 R336 | RESISTOR,6.04k | 0402_MM | Yageo | RC0402FR-076K04L | RES SMD 6.04K OHM 1% 1/16W 0402
145 | 2 | R328 R333 | RESISTOR,90.9k | 0402_MM | Yageo | RC0402FR-0790K9L | 90.9 kOhms ±1% 0.063W, 1/16W Chip Resistor 0402 (1005 Metric) Moisture Resistant Thick Film
146 | 89 | R48 R50 R58 R60 R62 R64 R66 R68-69 R71 R78 R83 R89-91 R97-98 R104 R107 R110-111 R162 R171 R176 R181 R186 R191 R196 R201 R206 R209-210 R214-215 R232 R236 R250 R254 R268 R272 R286 R290 R332 R337 R345 R347 R350 R352 R359-360 R373 R377 R391 R395 R409 R413 R427 R431 R434-435 R437 R441-442 R459 R463 R477 R481 R495 R499 R513 R517 R520-521 R524 R527-528 R545 R549 R563 R567 R581 R585 R599 R603 R645-646 R672 R674-675 | RESISTOR,DNI | 0402_MM | DNI | DNI
147 | 48 | A1A A1B A1C A1D A1E A1F A1G A1H A1I A1J A1K A1L A1M A1N A1O A1P A1Q A1R A1S A1T A1U A1V A1W A1X A2A A2B A2C A2D A2E A2F A2G A2H A2I A2J A2K A2L A2M A2N A2O A2P A2Q A2R A2S A2T A2U A2V A2W A2X | RFSA3713 | QFN50P300X300X60-16N | Qorvo | RFSA3713TR7 | 5MHz to 6000MHz, Digital Step Attenuator 16-pin QFN
148 | 66 | Q1-9 Q11-67 | RYE002N05 | SOT416 | Rohm | RE1C002UNTCL | MOSFET N-CH 20V 0.2A EMT3
149 | 1 | U67 | S25FLXXXS_FAC024_FAB024 | FAC024_FAB024 | Cypress | S25FL256SAGBHIA00 | NOR Flash Serial-SPI 3V/3.3V 256M-bit 256M x 1 8ns 24-Pin BGA Tray
150 | 24 | T1A T1B T1C T1D T1E T1F T1G T1H T1I T1J T1K T1L T1M T1N T1O T1P T1Q T1R T1S T1T T1U T1V T1W T1X | SBTC-2-10LX+ | SBTC210LX_6PAD | Mini-Circuits | SBTC-2-10LX+ | Signal Conditioning PWR SPLTR CMBD/SM /TOPHAT RoHS: NOTE - pin 5 is NOT PRESENT in this variant
151 | 6 | T2-7 | SCA-4-10+ | MINICIRCUITS-DZ943 | Mini-Circuits | SCA-4-10+ | Combiner/Splitter 1-IN 4-OUT 5MHz to 1000MHz 10-Pin Case DZ943 T/R
152 | 1 | U2 | SI5338N/P/Q | QFN50P400X400X9025N | Silicon Labs | SI5338N-B-GM | I2C CONTROL, 4-OUTPUT, ANY FREQU
153 | 1 | Q10 | SI7157DP-T1-GE3 | TRANS_SI7157DP-T1-GE3 | Vishay Siliconix | Si7157DP-T1-GE3 | P-Channel_20V_60A_(Tc)_6.25W_(Ta),_104W_(Tc)_Surface_Mount_PowerPAKÂ®_SO-8
154 | 2 | S1-2 | SKY13380-350LF | QFN50P300X300X60-16N | pSemi | PE42440MLBB-Z
155 | 30 | S10-15 S1A S1B S1C S1D S1E S1F S1G S1H S1I S1J S1K S1L S1M S1N S1O S1P S1Q S1R S1S S1T S1U S1V S1W S1X | SKYA21003 | QFN5-2X2-12-EP | Skyworks | SKYA21003 | IC RF SWITCH SPDT 6GHZ 12QFN
156 | 24 | D1A D1B D1C D1D D1E D1F D1G D1H D1I D1J D1K D1L D1M D1N D1O D1P D1Q D1R D1S D1T D1U D1V D1W D1X | SMS7621 | 0201_POL | Skyworks | SMS7621-040LF | RF DIODE SCHOTTKY 2V 75MW SOD882
157 | 23 | X3-6 X8-13 X15-16 X18-19 X21-28 X48 | SM_LED,Green | LED_0603 | Lite-On | LTST-C190KGKT | LED GREEN CLEAR CHIP SMD
158 | 7 | X1-2 X7 X14 X17 X20 X45 | SM_LED,Red | LED_0603 | Rohm | SML-D12V1WT86 | LED RED DIFFUSED 1608 SMD
159 | 1 | U41 | SPI_FLASH_SO8 | SO8MB | GigaDevice | GD25Q64CSIGR | Generic SPI Flash in an SO8 package (MB=208 mil, NB=150 mil).
160 | 2 | J6 J11 | TC2030-MCP-NL | TC2030-MCP-NL | DNI | DNI | Tag-Connect Footprint TC2030
161 | 1 | T1 | TCP-2-272+ | PL-008 | Mini-Circuits | TCP-2-272+ | Mini Circuits 2-Way Splitter 5-2700 MHz
162 | 24 | F1A F1B F1C F1D F1E F1F F1G F1H F1I F1J F1K F1L F1M F1N F1O F1P F1Q F1R F1S F1T F1U F1V F1W F1X | TDK_DEA16 | TDK_DEA16 | TDK | DEA160915LT-1169 | RF Filter Low Pass 915MHz 880MHz to 915MHz 0.7dB 50Ohm SMD 4Pin 0603 T/R
163 | 125 | TP1-46 TP48-73 TP75-127 | TESTPOINT | TP35 | DNI | DNI | Test Point
164 | 48 | TP128-175 | TESTPOINT_2MM | TP_2MM | DNI | DNI | Test Point
165 | 1 | U40 | TPS25982X | TPS259827LNRGET | Texas Instruments | TPS259823LNRGER | Texas Instruments 15A, 3m? eFuse with Accurate Current Monitor and Configurable Retry Timers 24-VQFN -40 to 125
166 | 2 | U21-22 | TPS54225PWPR | SOP65P640X120-15N | Texas Instruments | TPS54225PWPR | 4.5 V to 18 V input, 2 A synchronous step-down converter in HTSSOP package
167 | 1 | U19 | TPS54824RNVR | RNV0018BA | Texas Instruments | TPS54824RNVR | 4.5V to 17V Input, Current Mode, 8A Synchronous SWIFT&#153; Step-Down Converter
168 | 1 | U20 | TPS54824RNVR | RNV0018B | Texas Instruments | TPS54424RNVR | 4.5V to 17V Input, Current Mode, 4A Synchronous SWIFT&#153; Step-Down Converter
169 | 1 | U24 | TPS62147RGXR | TPS621361RGXT | Texas Instruments | TPS62147RGXR | 3-17V 2.0A Step-Down Converter with 1% accuracy and PFM/Forced-PWM in 2x3QFN
170 | 1 | U23 | TPS627451DSST | SON50P200X300X80-13N | Texas Instruments | TPS62745DSST | Conv DC-DC 3.3V to 10V Synchronous Step Down Single-Out 1.8V to 3.3V 0.3A 12-Pin WSON EP T/R
171 | 1 | V57 | VREF_SERIES,1.2V | SOT23 | Renesas | ISL60002DIH311Z-TK | Generic 3-Terminal series voltage reference, with VIN=1, VOUT=2, GND=3.
172 | 1 | L14 | XAL7070-182MEC | INDC7275X700N | COILCRAFT | XAL7070-182MEC | Fixed Inductors
173 | 1 | U12 | XC7A200TFBG676 | FG676 | Xilinx | XC7A200T-2FBG676I | FPGA Artix-7 Family 215360 Cells 28nm Technology 1V 676-Pin Lidless FCBGA
174 | 1 | L19 | XFL4020-222MEB | XFL4020-222ME | COILCRAFT | XFL4020-152MEB | Fixed Inductors 1.5uH 20% 9.1A 15.8mOhms AEC-Q200
175 | 7 | U7 U10 U17 U26 U29 U32 U36 | XRA1200PIG16TR-F | SOP65P640X120-16N | Texas Instruments | TCA9554APWR | Interface - I/O Expanders 8 Bit I2C SMBus GPIO Expander
