barawn/radiant/(threads)

Thread 1 (2020-02-15):

VTERM isn't generated anywhere and needs decoupling caps

barawn, 2020-02-15:
The 1.2V termination voltage for the trigger lines needs a voltage reference and decoupling caps at each point.

Based on what the routing looks like, most likely will have 2 voltage references, one for top side, and one for bottom side (12 channels each).

barawn, 2020-03-01:
Done, actually only needed one (joined on the right side).

Closed 2020-03-01.

Thread 2 (2020-05-14):

ECO list for RADIANTv1.1

barawn, 2020-05-14:
These are known ECOs needed for the next RADIANT revision.

- MASTER_CLK_N/MASTER_CLK_P need to be AC coupled before going into clock synthesizer.
- EN2V6/EN3V1/EN1V8/EN2V5/EN1V0 need weak pulldowns and a capacitor to ground to hold them during a board manager reset. ENMGT just needs a capacitor to ground.

barawn, 2020-05-20:
* SWDIO/SWDCLK need to be moved to pins 58/57 respectively.

barawn, 2020-05-21:
* BM_SDA/BM_SCL are missing pullups

barawn, 2020-05-21:
* U2 (the Si5338) is missing a polarity indicator and refdes on the silkscreen layer gerbers

barawn, 2020-05-22:
* U2 needs to be an Si5338 N/P/Q for Pin 4 to be available as a single ended feedback

barawn, 2020-05-26:
* Turn the SD card socket around, it faces inwards which is stupid
* Move the SD card to the onboard SPI (BM_MOSI/BM_MISO/etc.), it can't easily share. Add a TS3A5018 to switch between the two, the onboard SPI bus is way too long to run with the SD card.

barawn, 2020-06-02:
* add a button on reset

barawn, 2020-06-03:
* swap all the sideband signals A<->B

barawn, 2020-06-04:
* switch diode triggers to SOD882

barawn, 2020-09-03:
* [ ] fix the LAB4D power supply resistor as specified in BOM

barawn, 2020-10-08:
* [ ] move the right LF board mount points in by 50 mils

barawn, 2020-10-08:
* [ ] left side trigger-path LP filter
* [ ] right side trigger-path LP filter

Thread 4 (2023-02-23):

ECO list for RADIANTv3

barawn, 2023-02-23:
- [x] Full 4-pin switch control
- [x] Ground both exposed pads of PE42440
- [x] Redo high pass filter (C2,4A-X = 82 pF, C3A-X=27 pF)
- [ ] Replace couplers with filters
- [x] Re-tune 2.6V
- [ ] Re-tune 3.07V
- [ ] Add bulk decoupling to 5V (47 uF ceramic at input, tantalum polymer after power protection) - plus ESR tune resistors
- [ ] Add bulk decoupling to 2.6V
- [ ] Aux trig/in out on SMA
- [ ] Bottom fiducials

barawn, 2023-02-23:
- [x] Add 2x GPIO on FPGA and 1x on each CPLD

barawn, 2023-02-27:
- [] Call out U40 specifically as TPS259823. Any of TPS259823, 259824, or 259827 will work, but the '23 version is preferred due to the 7.6V over-voltage lockout.

barawn, 2023-03-01:
- [x] Fix paste on MIC94310-GYMT-TR (need paste mask on copper-associated pin)
- [x] Fix paste mask on U68 (NLSX5014MUTAG) (unassociate silkscreen copper from pad)
- [x] Fix silkscreen at C47 and around signal generator chip
- [x] Fix silkscreen in channel Q path
- [x] Replace Q10 footprint

barawn, 2023-03-02:
- [x] Put A2.6V and 3.07V available for monitoring by using the analog muxes in non-BIST mode. A2.6V is on QUAD2_MON and 3.07V is on QUAD3_MON.
- [x] Move BM_EN_10MHZ to PB31 (pin 60).
- [x] Connect VINMON to PB01. Note that ENVINMON must be high to read a real value.
- [x] Connect DBG_TX/DBG_RX to 10-pin SWD header via 0 ohm resistors. This allows DBG_TX/DBG_RX to be used as GPIOs if needed.

barawn, 2023-03-15:
- [x] Increase bulk decoupling to 4.7 uF on individual 3.0V and 2.5V regulators
- [x] Add 0.01 uF NP0 cap in parallel at 3.0V and 2.5V regulators for higher Q at mid frequencies
- [] Filter 3.3V supplied to attenuators and switches by putting feedthrough caps for left/right sides (creating A3.3VL and A3.3VR)

barawn, 2023-04-19:
- [x] Increase output decoupling caps on 2.5V regulator to 4.7u 0402 (0402ZD475KAT2A, already on board)
- [x] Increase output decoupling caps on 3.0V regulator to 1u 0402 (GRM155C81C105KE11J, already on board)

barawn, 2023-05-07:
- [x] Add 0603 feedthrough cap (can also be used as ferrite) to each LAB4D power supply input
- [x] Add 2 mm circle test points ( can be used w/SMOX ball test points) to 3.0V/2.5V outputs.
