barawn/radiant/(commit log)

2020-02-13 push schematic, horrible design doc
    [RADIANT_board_manager.xlsx]
2020-02-13 add real bom
    [radiant_bom.xlsx]
2020-02-13 R385 has correct value now
    [radiant_bom.xlsx]
2020-02-14 add magic to BOM
    [radiant_bom.xlsx]
2020-02-18 fix excel fail
    [radiant_bom.xlsx]
2020-02-25 update final bom
    [radiant_bom.xlsx]
2020-02-25 final schematic/bom
2020-02-25 add final gerbers, XYRS, BOM
    [radiant_bom.xlsx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]
2020-02-25 update minicircuits coupler
    [radiant_bom.xlsx]
2020-02-26 fix missing pullups on the missing aux CPLD INITs
    [radiant_bom.xlsx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]
2020-02-26 fix layer 3 pour issue
    [radiantv1.gtl]
2020-02-26 add missing pin 1 indicator on board manager
    [radiant_bom.xlsx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]
2020-02-26 fix part number for JTAG connector
    [radiant_bom.xlsx]
2020-02-26 enlarge USB-C connector slots to 0.5 mm
    [radiantv1.gbl, radiantv1.gbs, radiantv1.gtl, radiantv1.gts]
2020-02-27 connect unused bank power to ground
    [radiantv1.gbl, radiantv1.gtl, radiantv1.gto]
2020-02-27 update schematic with unused bank power grounds
2020-02-27 really connect all grounds
    [radiant_bom.xlsx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]
2020-02-27 fix part number for 3.3V regulator
2020-02-27 update inductor to larger size/correct value, fix BOM for 3.3V regulator
    [radiant_bom.xlsx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]
2020-02-27 clarify a few things on the BOM
    [radiant_bom.xlsx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]
2020-02-27 drop J6/J11 from the paste mask output so their pads stay clear
    [radiantv1.gtp]
2020-03-03 fixed line items 44, 120, 128 (wrong p/n). line item 150 was a duplicate, deleted
    [radiant_bom.xlsx]
2020-03-03 make sure BOM is updated
    [radiant_bom.xlsx]
2020-03-03 fix line item 38
    [radiant_bom.xlsx]
2020-10-15 update to v2 schematic
2020-10-15 add radiantv2 CAM files
    [radiantv2.gbl, radiantv2.gbo, radiantv2.gbp, radiantv2.gbs, radiantv2.gtl, radiantv2.gto, radiantv2.gtp, radiantv2.gts]
2020-10-15 update CAM files
    [radiantv1.gbl, radiantv1.gbo, radiantv1.gbp, radiantv1.gbs, radiantv1.gtl, radiantv1.gto, radiantv1.gtp, radiantv1.gts]
2020-10-15 update gerbers to fix a few noconnects
    [radiantv2.gbl, radiantv2.gbo, radiantv2.gbp, radiantv2.gbs, radiantv2.gtl]
2020-10-16 update schematic to B/W
2020-10-22 update BOM/XYRS
    [radiant_bom.xlsx]
2020-10-22 pass everything
    [radiantv2.gbl, radiantv2.gbo, radiantv2.gtl, radiantv2.gto]
2020-10-23 update to only put LP filt on surface antennas
    [radiant_bom.xlsx]
2020-10-23 fix part number for 12.7k resistor
    [radiant_bom.xlsx]
2020-10-23 schematic w/part numbers updated
2020-10-23 update red LED part # for available type
    [radiant_bom.xlsx]
2020-10-23 update MIC94310 for more available package type
    [radiant_bom.xlsx]
2021-03-02 add board bringup documentation
2022-04-08 update auxcpld to correct mapping
    [radiant_aux.v]
2023-03-03 RADIANTv3 files
    [radiant_v3_bom.xlsx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]
2023-03-03 add schematic
2023-03-15 update to v3 031523
    [radiant_v3_bom.xlsx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]
2023-03-16 add 031523 schematic
2023-04-19 change output caps on local regulators to recommended min
    [radiant_v3_bom.xlsx]
2023-05-06 add feedthrough cap on LAB4 and testpoints for LAB4 and trig outputs
    [radiantv3.gbl, radiantv3.gbo, radiantv3.gbp, radiantv3.gbs, radiantv3.gtl, radiantv3.gto, radiantv3.gtp, radiantv3.gts]
2023-05-06 add 05/05 radiant schematic
2023-05-08 update BOM for added feedthrough caps + test points
    [radiant_v3_bom.xlsx]
2023-07-19 update radiant_v3_bom to unify splitter lines
    [radiant_v3_bom.xlsx]
2023-07-19 really update BOM
    [radiant_v3_bom.xlsx]
